k3idi/Ferrofluid-Display/media/FD_BOARD_SOLDERED.PNG

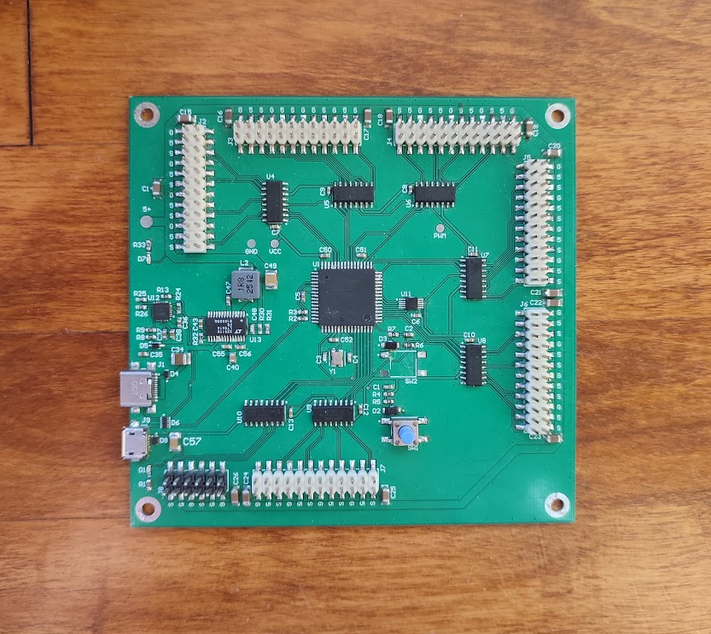
media/FD_BOARD_SOLDERED.PNG
