k3idi/Ferrofluid-Display/media/FD_BOARD_UNSOLDERED.PNG

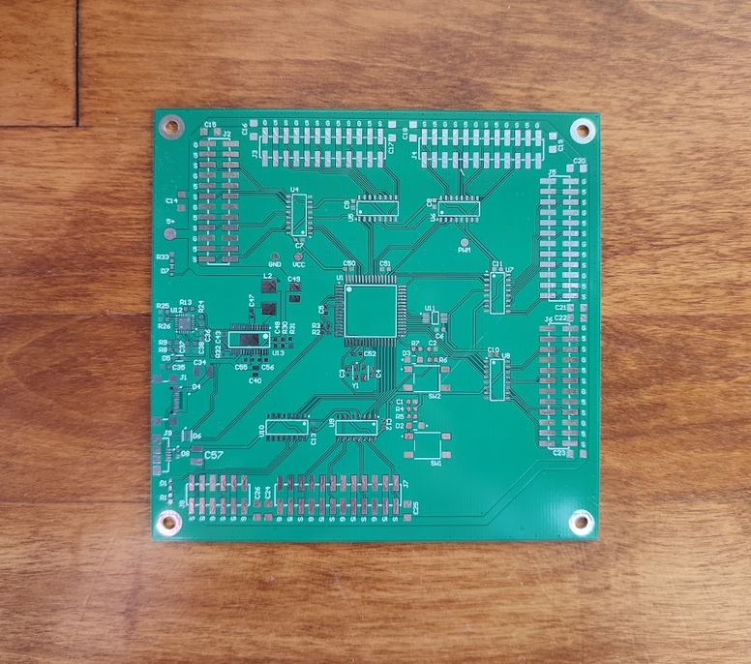
media/FD_BOARD_UNSOLDERED.PNG
