k3idi/Ferrofluid-Display/(commit log)

2026-10-18 Added pictures of the board from Altium.
2026-10-19 Added explanations of the sections of the PCB.
2026-10-19 Added PCB design files.
